hugodbn/Gustave-Avionics-Telemetry/README.md

# Gustave Avionics & Telemetry System

Experimental rocket avionics platform developed within AeroIPSA.

<p align="center">
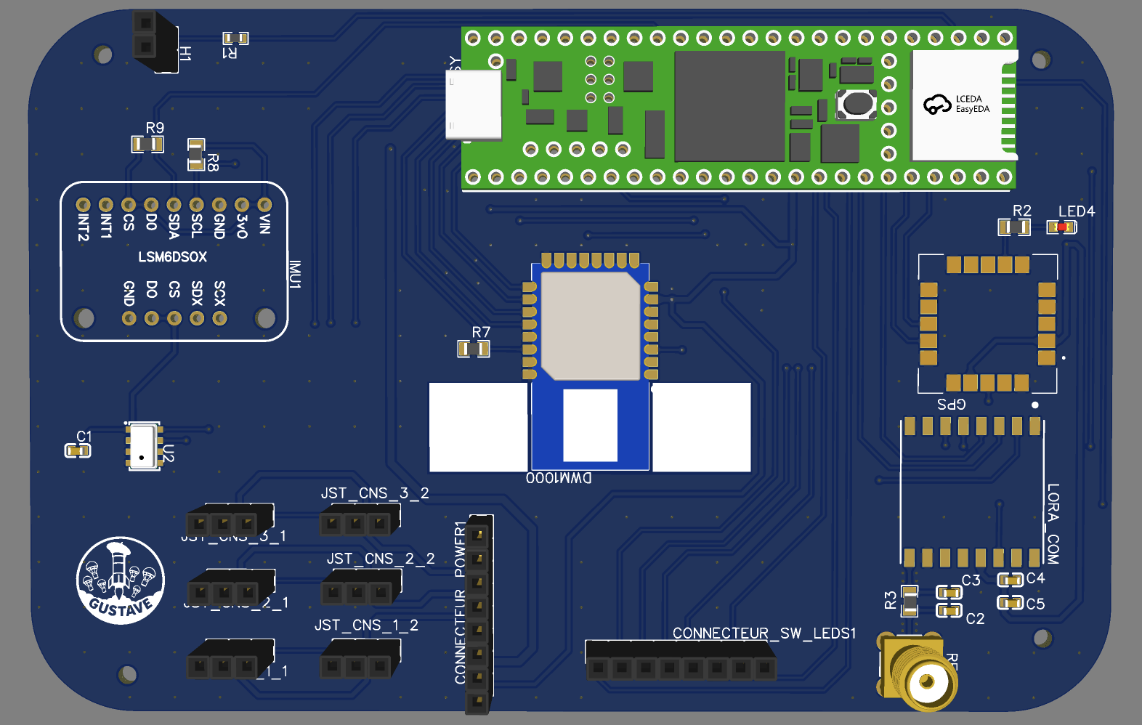
[picture p1: Images/PCB-3D-Experience.png]
PCB Top View
  
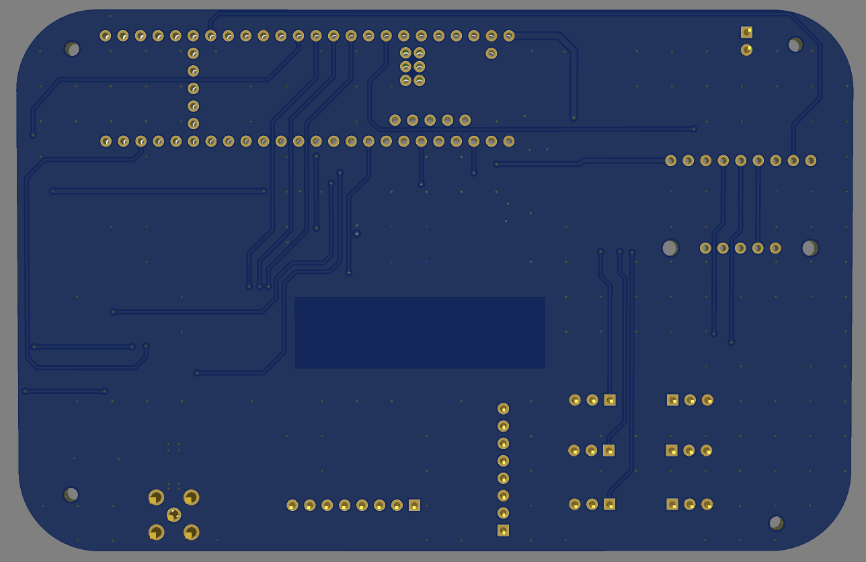
[picture p2: Images/PCB-bottom-3d.png]
PCB Bottom View
  
</p>

## Overview

Gustave is an experimental rocket developed within AeroIPSA, IPSA's student aerospace association, with a planned launch in March 2027.

The avionics system is responsible for:

- Flight telemetry
- CanSat deployment
- UWB-based positioning between rocket and CanSats logged for post-flight trajectory reconstruction
- Sensor acquisition
- Onboard data logging

## Features

- 4-layer avionics PCB (GND-5V-5V-GND stack up) plus a dedicated PCB for each CanSat
- ARM Cortex-M7 firmware (Teensy 4.1)
- LoRa wireless telemetry
- DW1000 UWB ranging
- GPS positioning
- IMU integration
- Barometric altitude measurement
- SD card data logging
- PWM-based CanSat release, triggered after acceleration-based launch detection (currently tested via a manual switch, with the final logic computing a precise delay from the rocket's internal timer); once released, each CanSat splits into two halves via a servo after a set delay

### System Architecture & Communication Buses

| Subsystem / Sensor | Interface | Role / Description |
| :--- | :--- | :--- |
| **Microcontroller (MCU)** | — | Main flight computer & data processing |
| **IMU** | I2C | High-rate acceleration & angular velocity tracking |
| **Pressure Sensor** | I2C | High-precision barometric altitude estimation |
| **GPS Module** | UART | Absolute positioning & GPS time synchronization |
| **UWB Module** | SPI | High-precision ranging & CanSat relative tracking |
| **LoRa Module** | SPI | Long-range down-link ground telemetry |
| **MicroSD Card** | SDIO / SPI | High-frequency sensor logging & redundancy |
| **CanSat Release System** | PWM | Acceleration-triggered deployment |

## My contributions

### PCB Design
Designed and routed the complete 4-layer avionics PCB for the rocket using EasyEDA, with component choices cross-checked with the team. Also contributed to validating the component selection for the CanSat PCBs, designed by another team member.

### Hardware & Schematics Overview

<p align="center">
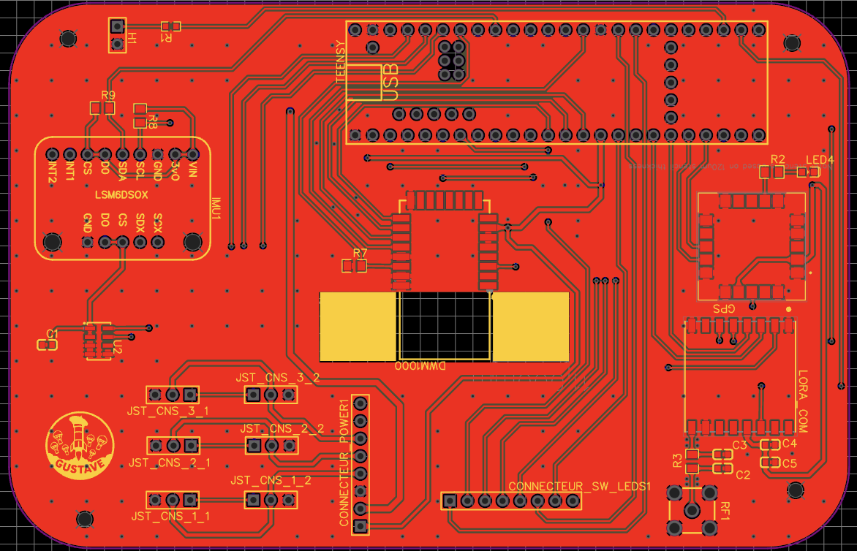
[picture p3: Images/PCB-layout-2d.png]
PCB 2D Layout
  
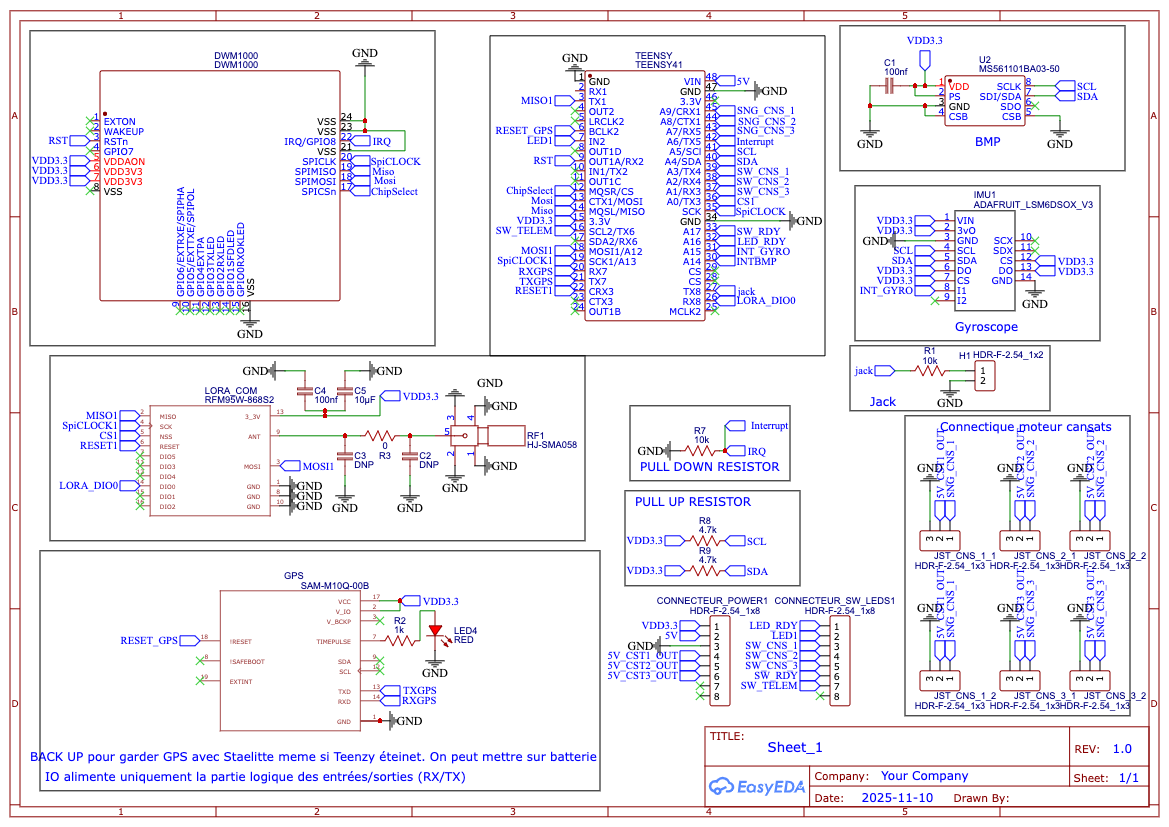
[picture p4: Images/schematic-overview.png]
Schematic Overview
  
</p>

### Component Selection & Integration
Contributed to selecting LoRa, DW1000 UWB, GPS, IMU and barometric sensors, validated collectively with the team, for real-time flight telemetry and CanSat localization.

### Embedded Firmware
Developed firmware using the Arduino framework on Teensy 4.1 (ARM Cortex-M7) for both the rocket and CanSat boards, implementing UART, SPI and I2C communication with onboard peripherals, and PWM-based CanSat release triggered after acceleration-based launch detection.

### Data Logging
Implemented onboard SD card logging of UWB ranging and sensor data during flight enabling post-flight trajectory reconstruction and fixed a race condition in the logging firmware to ensure data integrity.

### Wireless Communication
Configured the DW1000 UWB ranging link between the rocket and CanSats on Channel 5 (110 kbps, PRF 64 MHz) setting the TX power register per Qorvo/Decawave's manufacturer-certified reference values (Table 20, DW1000 User Manual) to ensure regulatory spectral compliance.

## Technologies

- MCU: Teensy 4.1 (ARM Cortex-M7)
- PCB Design: EasyEDA
- Languages: C, C++
- Framework: Arduino
- Protocols: UART, SPI, I2C, PWM
- Wireless: LoRa, DW1000 UWB
- Sensors: GPS, IMU, Barometric sensor

## Repository Structure

```
Documentation
Firmware
Hardware
Images
LICENSE
README.md
```

## Roadmap

- [X] PCB design
- [X] Component selection
- [X] Firmware development
- [X] Sensor integration
- [ ] Full firmware integration testing (all components assembled together)
- [ ] LoRa range testing (scheduled February)
- [ ] Hardware Validation
- [ ] Flight testing
- [ ] Launch (March 2027)

## License

This repository is provided for portfolio and demonstration purposes only.
The hardware designs, firmware, documentation and other project materials may not be copied, modified or redistributed without prior permission from the author.

© 2026 Hugo Debionne. All rights reserved.
