hugodbn/Gustave-Avionics-Telemetry/Hardware/BOM.csv

ID | Name | Designator | Footprint | Quantity | Manufacturer Part | Manufacturer | Supplier Part
1 | 100nf | C1,C4 | C0603 | 2
2 | DNP | C2,C3 | C0603 | 2
3 | 10µF | C5 | C0603 | 1
4 | HDR-F-2.54_1x8 | CONNECTEUR_POWER1,CONNECTEUR_SW_LEDS1 | HDR-F-2.54_1X8 | 2 |  |  | C225505
5 | DWM1000 | DWM1000 | WIRELM-TH_DWM1000 | 1 | DWM1000 | decaWave | C95238
6 | SAM-M10Q-00B | GPS | XCVR_SAM-M10Q-00B | 1
7 | HDR-F-2.54_1x2 | H1 | HDR-F-2.54_1X2 | 1 |  |  | C49661
8 | ADAFRUIT_LSM6DSOX_V3 | IMU1 | LSM6DSOX | 1 | PM254-1-09-Z-3.0-C | HCTL(华灿天禄) | C5156450
9 | HDR-F-2.54_1x3 | JST_CNS_1_1,JST_CNS_1_2,JST_CNS_2_1,JST_CNS_2_2,JST_CNS_3_1,JST_CNS_3_2 | HDR-F-2.54_1X3 | 6 |  |  | C146690
10 | RED | LED4 | LED0603_RED | 1 | 19-217/R6C-AL1M2VY/3T | EVERLIGHT(台湾亿光) | C72044
11 | RFM95W-868S2 | LORA_COM | XCVR_RFM95W-868S2 | 1
12 | 10k | R1 | R0603 | 1
13 | 1k | R2 | R0805 | 1
14 | 0 | R3 | R0805 | 1
15 | 10k | R7 | R0805 | 1
16 | 4.7k | R8,R9 | R0805 | 2
17 | HJ-SMA058 | RF1 | SMA-TH_BWSMA-KE-Z001 | 1 | HJ-SMA058 | 皇捷 | C2693814
18 | TEENSY41 | TEENSY | COMM-TH_L60.1-W17.8-P2.54 | 1 | TEENSY41 | null | C9900133442
19 | MS561101BA03-50 | U2 | SENSORS-SMD_MS5611-01BA03 | 1 | MS561101BA03-50 | TE Connectivity(泰科电子) | C15639
