hugodbn/Gustave-Avionics-Telemetry/Hardware/Schematic.pdf

## BMP

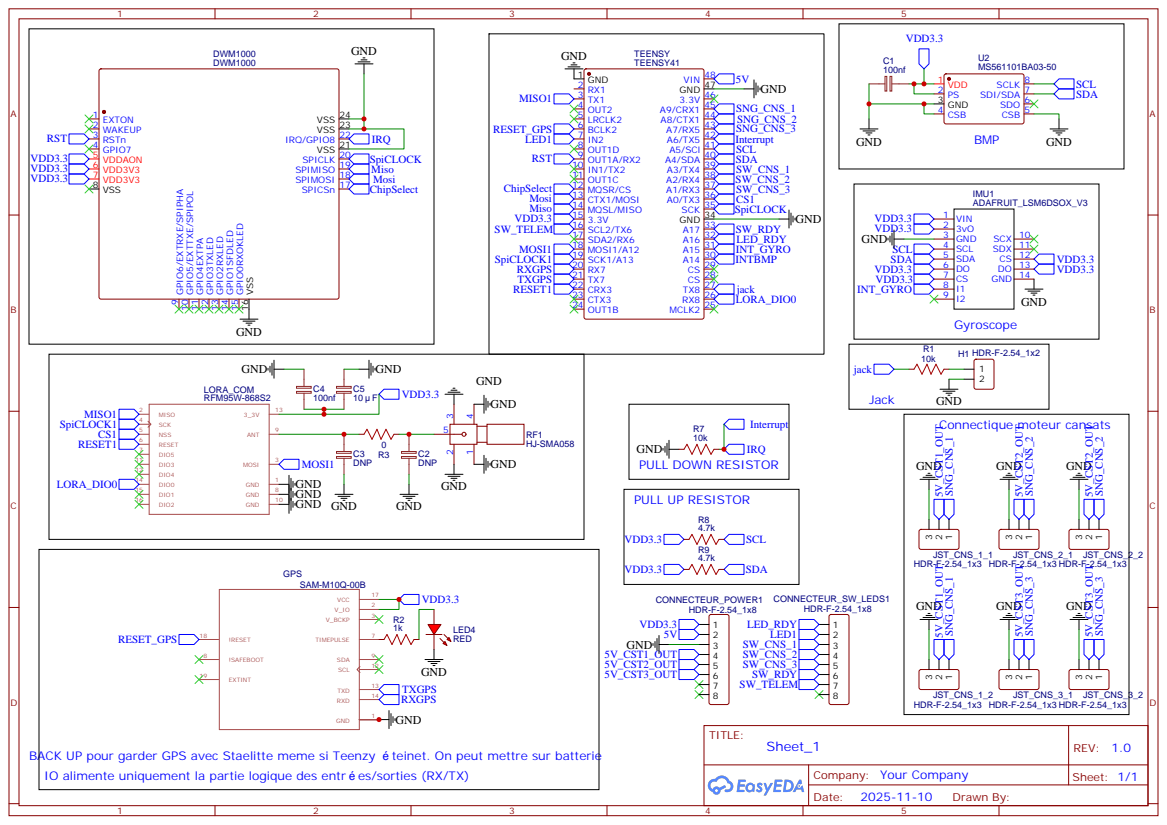
[picture p5: page 1]

SPICSn 17 SPIMOSI 18 SPIMISO 19 SPICLK 20 VSS 21 IRQ/GPIO8 22 VSS 23 VSS 24

BACK UP pour garder GPS avec Staelitte meme si Teenzy teinet. On peut mettre sur batterie
IO alimente uniquement la partie logique des entr es/sorties (RX/TX)
